IUEngineering/gardenLightsRGBW/LEDmodule/spice/supply.asc

C1: cap; 100µ
C2: cap; 100µ
C3: cap; 1µ
C4: cap; 1µ
C5: cap; 10m
D1: diode; idealDiode
D2: diode; idealDiode
D3: diode; idealDiode
D4: diode; idealDiode
D5: diode; ss16fp
D6: diode; ss16fp
D7: diode; ss16fp
D8: diode; ss16fp
D9: diode; ss16fp
D10: diode; ss16fp
D11: diode; ss16fp
D12: diode; ss16fp
L1: ind; {serL}
L2: ind; {serL}
L3: ind; {serL}
L4: ind; {serL}
L5: ind; {serL}
L6: ind; {serL}
Q1: npn; 2PD601ARL
Q2: npn; 2PD601ARL
Q3: npn; 2PD601ARL
Q4: npn; 2PD601ARL
Q5: npn; 2PD601ARL
Q6: npn; 2PD601ARL
R1: res; {load}
R2: res; {load}
R3: res; 10k
R4: res; 10k
R5: res; {load}
V1: voltage; PULSE(0 24 0.2 1u 0 10); AC 1
V2: voltage; PULSE(0 24 0.2 1u 0 10); AC 1
V3: voltage; PULSE(0 24 0.2 1u 0 10); AC 1
Named nets: 0, recOut1, recOut2, recOut3
.model idealDiode D(Ron=1m Roff=1Meg Vfwd=0 Vrev=200)
.tran 0 1 0
.param load 240
* DIODES INCORPORATED AND ITS AFFILIATED COMPANIES AND SUBSIDIARIES (COLLECTIVELY, "DIODES") 
* PROVIDE THESE SPICE MODELS AND DATA (COLLECTIVELY, THE "SM DATA") "AS IS" AND WITHOUT ANY 
* REPRESENTATIONS OR WARRANTIES, EXPRESS OR IMPLIED, INCLUDING ANY WARRANTY OF MERCHANTABILITY 
* OR FITNESS FOR A PARTICULAR PURPOSE, ANY WARRANTY ARISING FROM COURSE OF DEALING OR COURSE OF 
* PERFORMANCE, OR ANY WARRANTY THAT ACCESS TO OR OPERATION OF THE SM DATA WILL BE UNINTERRUPTED, 
* OR THAT THE SM DATA OR ANY SIMULATION USING THE SM DATA WILL BE ERROR FREE. TO THE MAXIMUM 
* EXTENT PERMITTED BY LAW, IN NO EVENT WILL DIODES BE LIABLE FOR ANY DIRECT OR INDIRECT, 
* SPECIAL, INCIDENTAL, PUNITIVE OR CONSEQUENTIAL DAMAGES ARISING OUT OF OR IN CONNECTION WITH 
* THE PRODUCTION OR USE OF SM DATA, HOWEVER CAUSED AND UNDER WHATEVER CAUSE OF ACTION OR THEORY 
* OF LIABILITY BROUGHT (INCLUDING, WITHOUT LIMITATION, UNDER ANY CONTRACT, NEGLIGENCE OR OTHER 
* TORT THEORY OF LIABILITY), EVEN IF DIODES HAS BEEN ADVISED OF THE POSSIBILITY OF SUCH DAMAGES, 
* AND DIODES' TOTAL LIABILITY (WHETHER IN CONTRACT, TORT OR OTHERWISE) WITH REGARD TO THE SM 
* DATA WILL NOT, IN THE AGGREGATE, EXCEED ANY SUMS PAID BY YOU TO DIODES FOR THE SM DATA.
 
 
 
*SRC=1N4007;DI_1N4007;Diodes;Si;  1.00kV  1.00A  3.00us   Diodes, Inc. diode
.MODEL DI_1N4007 D  ( IS=76.9p RS=42.0m BV=1.00k IBV=5.00u
+ CJO=26.5p  M=0.333 N=1.45 TT=4.32u )
.model ss16fp D(BV=60 IBV=0.4 Cj=54p RS=1)
.param serL 8m
***********************************************************
*
* 2PD601ARL
*
* Nexperia
*
* General purpose NPN Transistor
* IC   = 100 mA
* VCEO = 50 V 
* hFE  = 210 - 340 @ 10V/2mA
*
*
*
*
* Package pinning does not match Spice model pinning.
* Package: SOT 23
* 
* Package Pin 1: Base
* Package Pin 2: Emitter
* Package Pin 3: Collector
*
*
* Extraction date (week/year): 41/2008  
* Spicemodel does not include temperature dependency
*
**********************************************************
*#
* Please note: Diode D1 is dedicated to improve modeling in reverse
* mode of operation and does not reflect a physical device.
*
.SUBCKT 2PD601ARL 1 2 3
Q1 1 2 3 MAIN
D1 2 1 DIODE
*
.MODEL MAIN NPN 
+ IS = 1.45E-014 
+ NF = 0.9921 
+ ISE = 1.465E-015 
+ NE = 1.384 
+ BF = 260 
+ IKF = 0.06839 
+ VAF = 29.79 
+ NR = 0.9937 
+ ISC = 6.681E-015 
+ NC = 1.085 
+ BR = 14.64 
+ IKR = 0.06762 
+ VAR = 20 
+ RB = 55 
+ IRB = 0.0003 
+ RBM = 5.5 
+ RE = 0.5 
+ RC = 0.4493 
+ XTB = 0 
+ EG = 1.11 
+ XTI = 3 
+ CJE = 1.407E-011 
+ VJE = 0.738 
+ MJE = 0.363 
+ TF = 5.8E-010 
+ XTF = 30 
+ VTF = 3 
+ ITF = 0.6 
+ PTF = 0 
+ CJC = 4.129E-012 
+ VJC = 0.3795 
+ MJC = 0.3304 
+ XCJC = 1 
+ TR = 4E-008 
+ CJS = 0 
+ VJS = 0.75 
+ MJS = 0.333 
+ FC = 0.78 
.MODEL DIODE D 
+ IS = 4.455E-017 
+ N = 0.8617 
+ BV = 1000 
+ IBV = 0.001 
+ RS = 1.198E+004 
+ CJO = 0 
+ VJ = 1 
+ M = 0.5 
+ FC = 0 
+ TT = 0 
+ EG = 1.11 
+ XTI = 3 
.ENDS
*
