IUEngineering/gardenLightsRGBW/(commit log)

2025-04-28 Add gitignore for kicad project
2025-04-28 Add initial kicad project setup
    [LEDmodule.kicad_pcb, LEDmodule.kicad_sch, communication.kicad_sch, inputProtection.kicad_sch, ledAndDriver.kicad_sch, mcu.kicad_sch, power.kicad_sch]
2025-04-28 Add the input protection circuit to the schematic
    [inputProtection.kicad_sch]
2025-04-29 Add LP5012RUK symbol
    [LEDmodule.kicad_sch, inputProtection.kicad_sch, ledAndDriver.kicad_sch]
2025-04-30 Added ledDriver without LED's
    [ledAndDriver.kicad_sch]
2025-04-30 Finalize Led&Driver
    [LEDmodule.kicad_sch, ledAndDriver.kicad_sch, mcu.kicad_sch]
2025-05-07 Initial buck converter design
    [power.kicad_sch]
2025-05-12 Add start of comm's
    [LEDmodule.kicad_sch, communication.kicad_sch, inputProtection.kicad_sch, ledAndDriver.kicad_sch, mcu.kicad_sch, power.kicad_sch]
